Likith-Kasam/HydraSense/hardware/Components-Invoices/sky-electro-tech (2).jpg

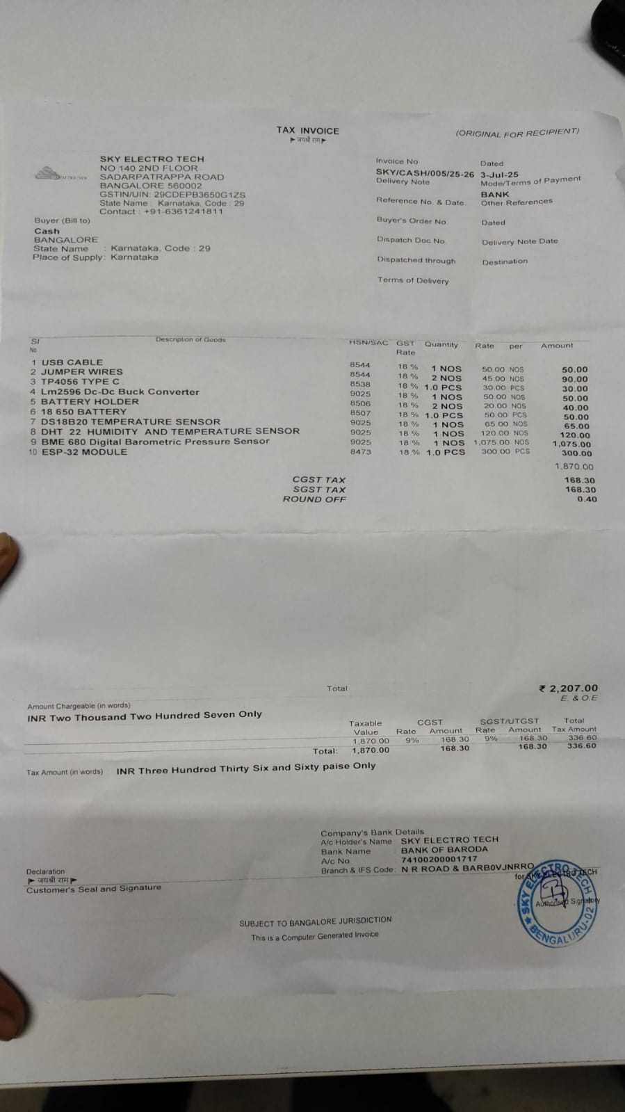
hardware/Components-Invoices/sky-electro-tech (2).jpg
