Likith-Kasam/HydraSense/hardware/Components-Invoices/sky-electro-tech(mehta).jpg

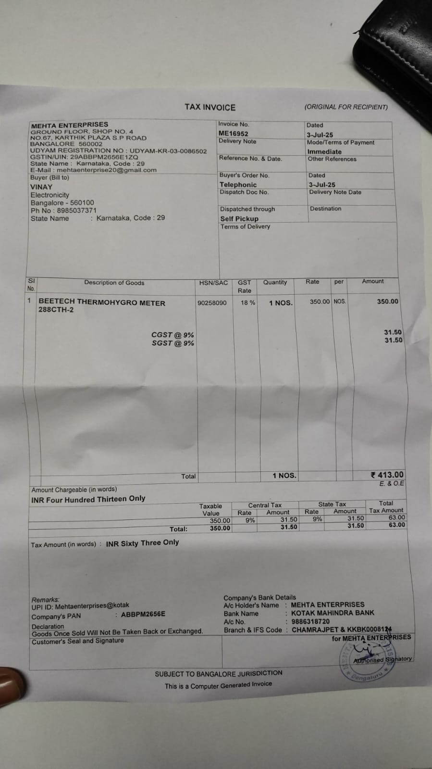
hardware/Components-Invoices/sky-electro-tech(mehta).jpg
