Likith-Kasam/HydraSense/demo/Hydra sense.pdf

# Hydra Sense

# TRL-8 Validated Cold Chain Monitoring

# ELCIIA

I T

# BANGALORE

# IIIT BANGALORE

# Team Members-LIKITH TARAL VINAY

# Team Members-LIKITH TARAL VINAY

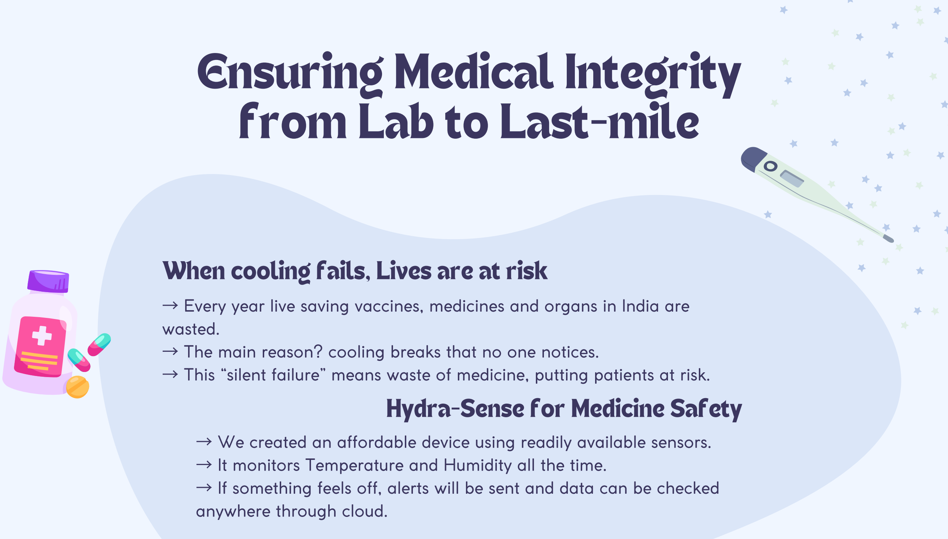
[picture p3: figure]
wasted.; → This; silent failure; When cooling fails, Lives are at risk; → We created an affordable; device using readily available sensors.; anywhere through cloud.; Hydra-Sense for Medicine Safety; Ensuring Medical Integrity from Lab to Last-mile

→ Every year live saving vaccines, medicines and organs in India are

→ The main reason? cooling breaks that no one notices.

means waste of medicine, putting patients at risk.

→ It monitors Temperature and Humidity all the time.

→ If something feels off, alerts will be sent and data can be checked

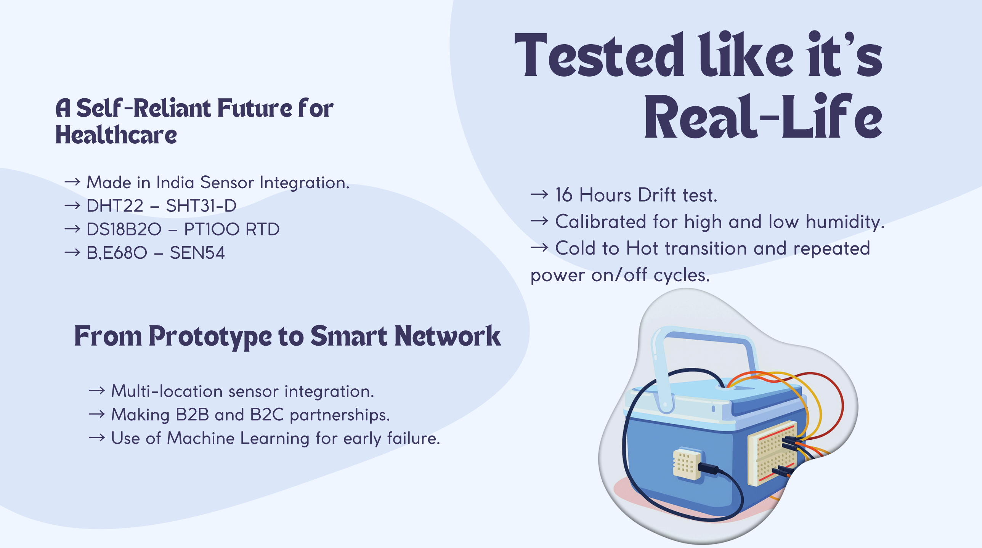
[picture p4: figure]
→ Made in India Sensor Integration.; → DHT22 – SHT31-D; → DS18B20 – PT100 RTD; → B,E680 – SEN54; → 16 Hours Drift test.; → Calibrated for high and low humidity.; → Cold to Hot transition and repeated; power on/off cycles.; A Self-Reliant Future for Healthcare; Tested like it’s Real-Life; From Prototype to Smart Network; → Multi-location sensor integration.; → Making B2B and B2C partnerships.

→ Use of Machine Learning for early failure.

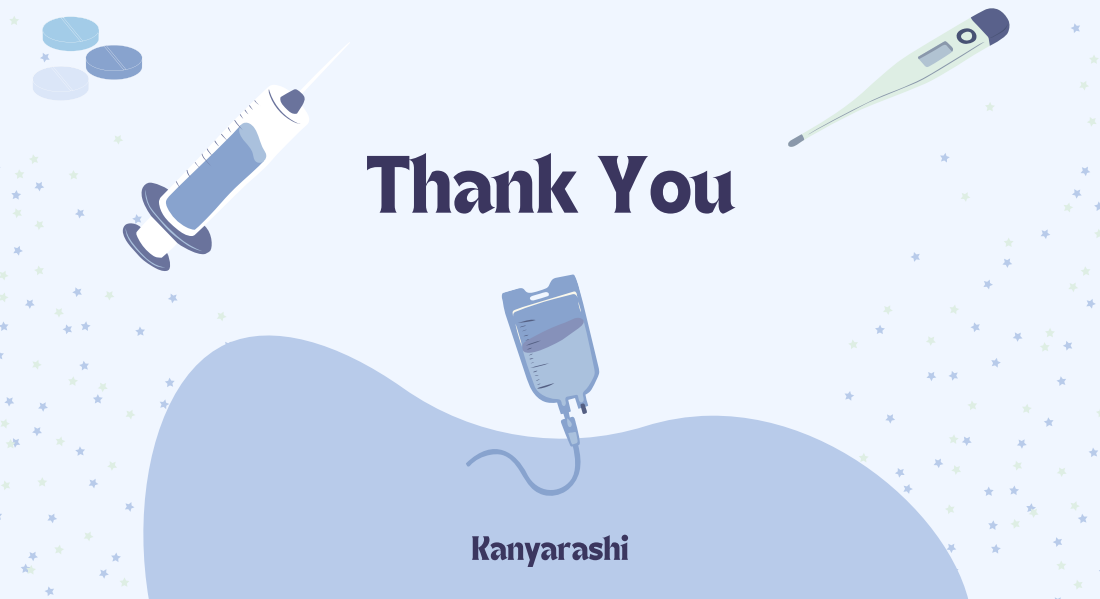
[picture p5: page 4]
Thank You; Kanyarashi
