Likith-Kasam/HydraSense/hardware/Circuit Diagram.jpg

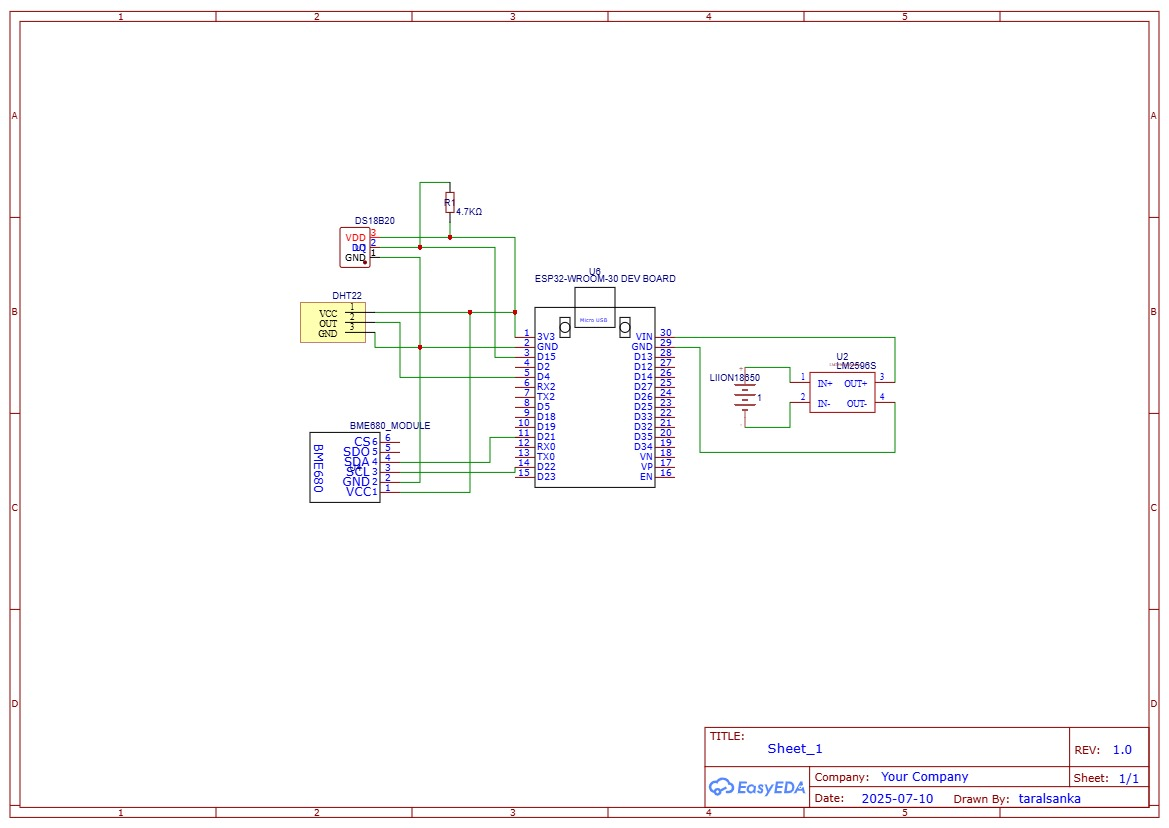
hardware/Circuit Diagram.jpg
