Likith-Kasam/HydraSense/test logs/screenshots/water-setup.png

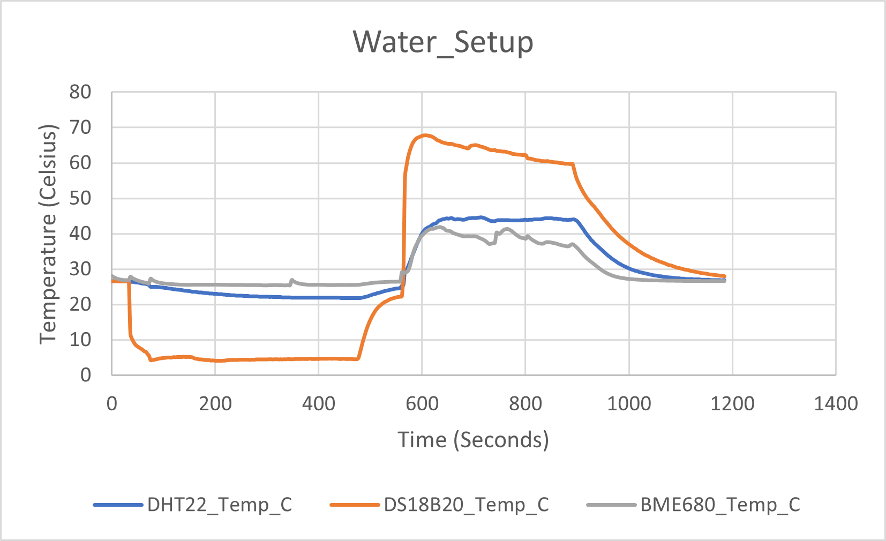
test logs/screenshots/water-setup.png
