Likith-Kasam/HydraSense/test logs/test-case-sensordata/16Hours_Data_Logging.csv

Time | DHT22_Temp | DS18B20_Temp | BME680_Temp | BME680_Humidity | DHT22_Humidity | BME680 - DS18B20 | BME680 - DHT22 Temp | DHT22 - BME680 (Humidity)
0 | 25.1 | 24.94 | 25.71 | 79.12 | 82.2 | 0.77 | 0.609999999999999 | 3.08
3 | 25.1 | 24.94 | 25.71 | 79.13 | 82.2 | 0.77 | 0.609999999999999 | 3.07000000000001
6 | 25.1 | 24.94 | 25.71 | 79.14 | 82.2 | 0.77 | 0.609999999999999 | 3.06
9 | 25.1 | 24.94 | 25.7 | 79.13 | 82.2 | 0.759999999999998 | 0.599999999999998 | 3.07000000000001
12 | 25.1 | 24.94 | 25.7 | 79.14 | 82.2 | 0.759999999999998 | 0.599999999999998 | 3.06
15 | 25.1 | 24.94 | 25.7 | 79.15 | 82.2 | 0.759999999999998 | 0.599999999999998 | 3.05
18 | 25.1 | 24.94 | 25.7 | 79.17 | 82.2 | 0.759999999999998 | 0.599999999999998 | 3.03
21 | 25.1 | 24.94 | 25.7 | 79.15 | 82.3 | 0.759999999999998 | 0.599999999999998 | 3.14999999999999
24 | 25.1 | 24.94 | 25.7 | 79.17 | 82.3 | 0.759999999999998 | 0.599999999999998 | 3.13
27 | 25.1 | 24.94 | 25.7 | 79.17 | 82.3 | 0.759999999999998 | 0.599999999999998 | 3.13
30 | 25.1 | 24.94 | 25.69 | 79.17 | 82.3 | 0.75 | 0.59 | 3.13
33 | 25.1 | 24.94 | 25.69 | 79.18 | 82.2 | 0.75 | 0.59 | 3.02
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
