Likith-Kasam/HydraSense/test logs/test-case-sensordata/Air_Testing.csv

Time | DHT22_Humidity_% | BME680_Humidity_%
0 | 74.8 | 76.36
3 | 74.9 | 75.85
6 | 74.9 | 76.32
9 | 74.9 | 76.66
12 | 74.8 | 76.74
15 | 74.8 | 76.7
18 | 74.9 | 76.63
21 | 75 | 76.55
24 | 75 | 76.44
27 | 75 | 76.32
30 | 75 | 76.17
33 | 75 | 74.98
36 | 74.9 | 74.4
39 | 75 | 74.76
42 | 74.9 | 75.36
45 | 74.8 | 74.79
48 | 74.7 | 75.24
51 | 74.8 | 75.77
54 | 74.9 | 75.97
57 | 74.9 | 76.13
60 | 74.9 | 76.26
63 | 75 | 76.38
66 | 75.1 | 76.49
69 | 75.2 | 76.61
72 | 75.3 | 76.67
75 | 75.4 | 76.8
78 | 75.5 | 76.88
81 | 75.6 | 76.94
84 | 75.7 | 77.08
87 | 75.9 | 77.16
90 | 76 | 77.2
93 | 76.1 | 77.25
96 | 76.2 | 77.32
99 | 76.3 | 77.41
102 | 76.5 | 77.49
105 | 76.6 | 77.55
108 | 76.7 | 77.62
111 | 76.8 | 77.67
114 | 76.9 | 77.74
117 | 77 | 77.79
120 | 77.9 | 78.26
123 | 78 | 77.45
126 | 78.1 | 77.72
129 | 78.2 | 77.92
132 | 78.2 | 78.07
135 | 78.2 | 78.17
138 | 78.3 | 78.24
141 | 78.4 | 78.3
144 | 78.4 | 78.33
147 | 78.4 | 78.36
150 | 78.5 | 78.39
153 | 78.5 | 78.42
156 | 78.6 | 78.44
159 | 78.6 | 78.45
162 | 78.6 | 78.47
165 | 78.7 | 78.47
168 | 78.7 | 78.48
171 | 78.8 | 78.5
174 | 78.7 | 78.51
177 | 78.7 | 78.52
180 | 78.8 | 78.53
183 | 78.8 | 78.55
186 | 78.8 | 78.56
189 | 78.9 | 78.55
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
