Likith-Kasam/HydraSense/test logs/test-case-sensordata/Salt_Slurry.csv

Time | DHT22 Humidity | BME680 Humidity | Target_75%
0 | 72.1 | 73.97 | 75
3 | 72.3 | 73.1 | 75
6 | 72.5 | 73.4 | 75
9 | 72.5 | 73.84 | 75
12 | 72.7 | 73.13 | 75
15 | 72.9 | 72.9 | 75
18 | 73.1 | 72.93 | 75
21 | 73.2 | 73.11 | 75
24 | 73.4 | 73.27 | 75
27 | 73.5 | 73.46 | 75
30 | 73.7 | 73.58 | 75
33 | 73.8 | 73.7 | 75
36 | 73.9 | 73.8 | 75
39 | 74 | 73.89 | 75
42 | 74 | 73.93 | 75
45 | 74.1 | 73.98 | 75
48 | 74.2 | 74.07 | 75
51 | 74.2 | 74.14 | 75
54 | 74.3 | 74.18 | 75
57 | 74.4 | 74.27 | 75
60 | 74.5 | 74.29 | 75
63 | 74.5 | 74.34 | 75
66 | 74.5 | 74.34 | 75
69 | 74.6 | 74.39 | 75
72 | 74.7 | 74.42 | 75
75 | 74.7 | 74.45 | 75
78 | 74.8 | 74.48 | 75
81 | 74.8 | 74.51 | 75
84 | 74.9 | 74.52 | 75
87 | 74.9 | 74.56 | 75
90 | 74.9 | 74.57 | 75
93 | 75 | 74.59 | 75
96 | 75 | 74.6 | 75
99 | 75.1 | 74.6 | 75
102 | 75 | 74.63 | 75
105 | 75.1 | 74.63 | 75
108 | 75.1 | 74.65 | 75
111 | 75.1 | 74.67 | 75
114 | 75.2 | 74.67 | 75
117 | 75.2 | 74.69 | 75
120 | 75.2 | 74.69 | 75
123 | 75.2 | 74.72 | 75
126 | 75.2 | 74.73 | 75
129 | 75.2 | 74.72 | 75
132 | 75.2 | 74.72 | 75
135 | 75.3 | 74.74 | 75
138 | 75.3 | 74.75 | 75
141 | 75.3 | 74.74 | 75
144 | 75.3 | 74.75 | 75
147 | 75.4 | 74.74 | 75
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
