Likith-Kasam/HydraSense/test logs/test-case-sensordata/Silica_Gel.csv

Time_Seconds | DHT22_Humidity (%) | BME680_Humidity (%)
0 | 81.88 | 79.87
3 | 82.25 | 79.84
6 | 82.02 | 79.66
9 | 81.61 | 79.85
12 | 81.33 | 79.39
15 | 81.03 | 79.52
18 | 80.94 | 79.39
21 | 81.51 | 79.12
24 | 80.95 | 79.26
27 | 81.04 | 78.9
30 | 80.16 | 78.92
33 | 80.57 | 78.53
36 | 80.57 | 78.36
39 | 80.11 | 78.53
42 | 79.81 | 78.35
45 | 80.29 | 78.19
48 | 79.78 | 77.94
51 | 79.64 | 78.2
54 | 79.58 | 77.54
57 | 79.35 | 77.4
60 | 79.41 | 77.7
63 | 78.69 | 77.56
66 | 79.2 | 77.33
69 | 79.11 | 77.08
72 | 79.04 | 77.11
75 | 78.84 | 77.22
78 | 78.47 | 77.26
81 | 78.17 | 76.29
84 | 78.4 | 76.41
87 | 77.87 | 76.27
90 | 77.85 | 76.56
93 | 77.75 | 75.61
96 | 77.55 | 76.08
99 | 77.67 | 75.79
102 | 77.6 | 76.04
105 | 77.07 | 75.88
108 | 77.11 | 75.52
111 | 76.42 | 75
114 | 76.6 | 75.07
117 | 76.47 | 74.95
120 | 76.36 | 74.65
123 | 76.38 | 75.01
126 | 75.77 | 74.35
129 | 76.2 | 74.9
132 | 75.22 | 74.76
135 | 75.45 | 74.16
138 | 75.12 | 74.17
141 | 75.45 | 73.95
144 | 75.18 | 74.01
147 | 74.75 | 73.94
150 | 75 | 73.6
153 | 75 | 73.51
156 | 74.58 | 73.15
159 | 74.17 | 73.23
162 | 74.35 | 73.03
165 | 74.17 | 72.68
168 | 73.76 | 72.72
171 | 73.46 | 72.51
174 | 73.08 | 72.33
177 | 73.32 | 72.09
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
