Likith-Kasam/HydraSense/test logs/screenshots/air-testing.png

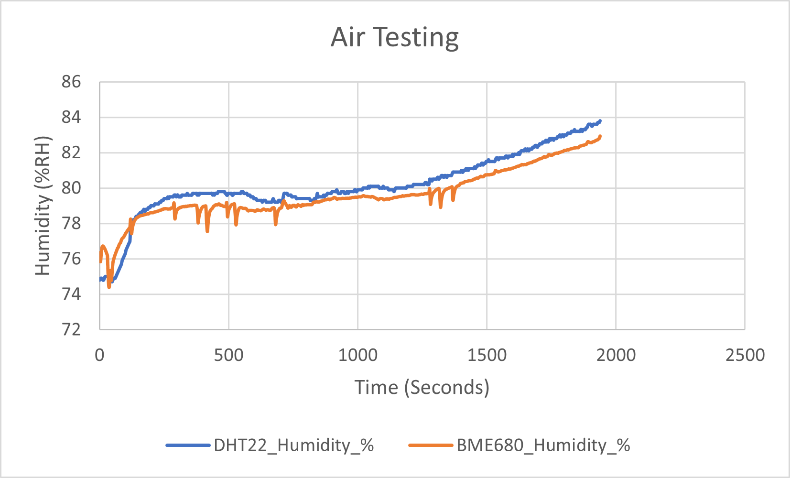
test logs/screenshots/air-testing.png
