Likith-Kasam/HydraSense/test logs/screenshots/blowing.png

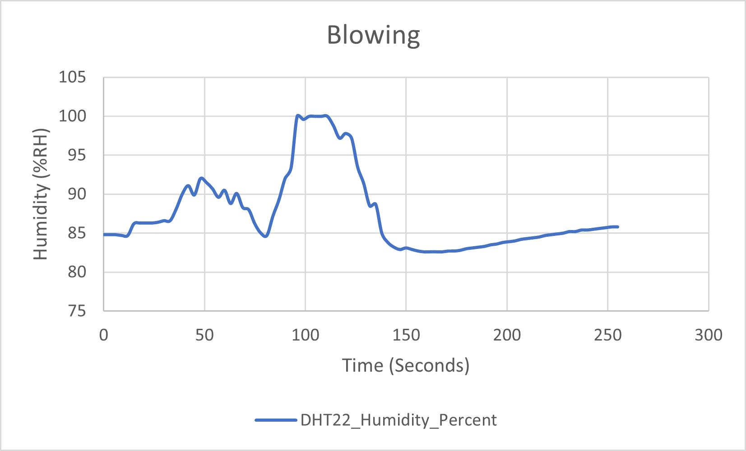
test logs/screenshots/blowing.png
