Likith-Kasam/HydraSense/test logs/screenshots/bme680-ds18b20(error).png

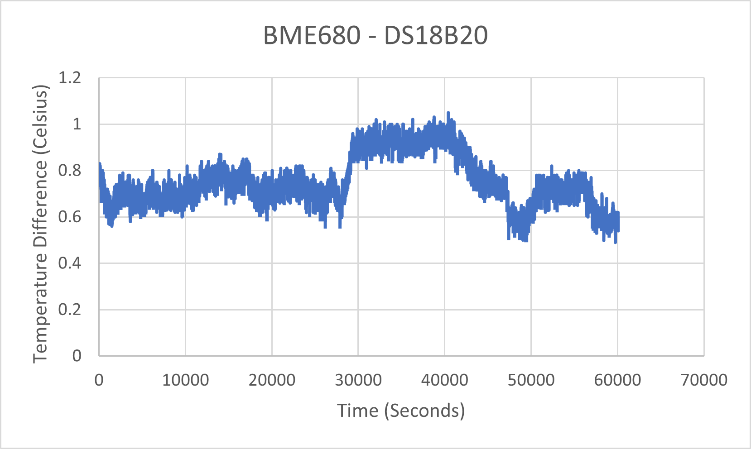
test logs/screenshots/bme680-ds18b20(error).png
