Likith-Kasam/HydraSense/test logs/screenshots/data-logging(temperature).png

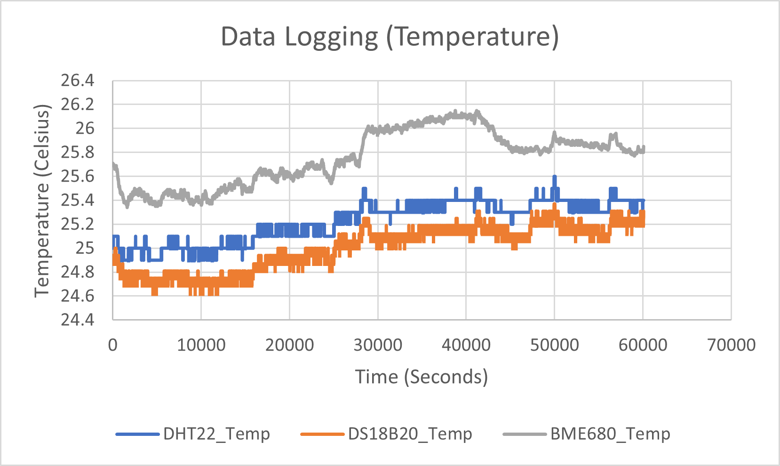
test logs/screenshots/data-logging(temperature).png
