Likith-Kasam/HydraSense/test logs/screenshots/salt-slurry.png

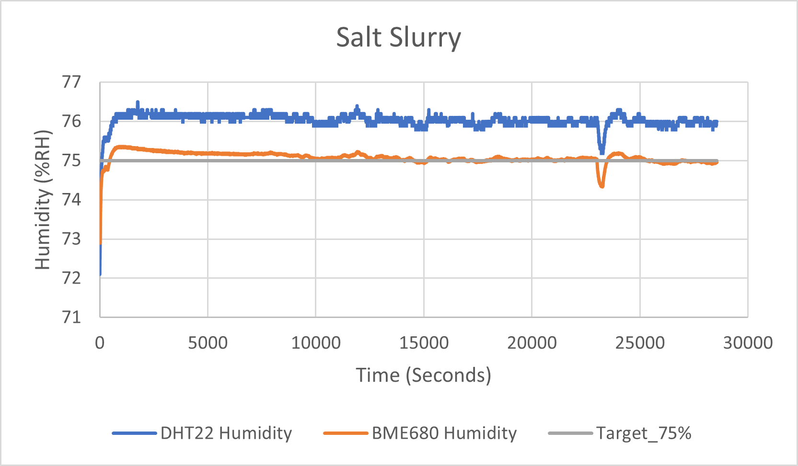
test logs/screenshots/salt-slurry.png
