Likith-Kasam/HydraSense/test logs/screenshots/Serial-Monitor.jpg

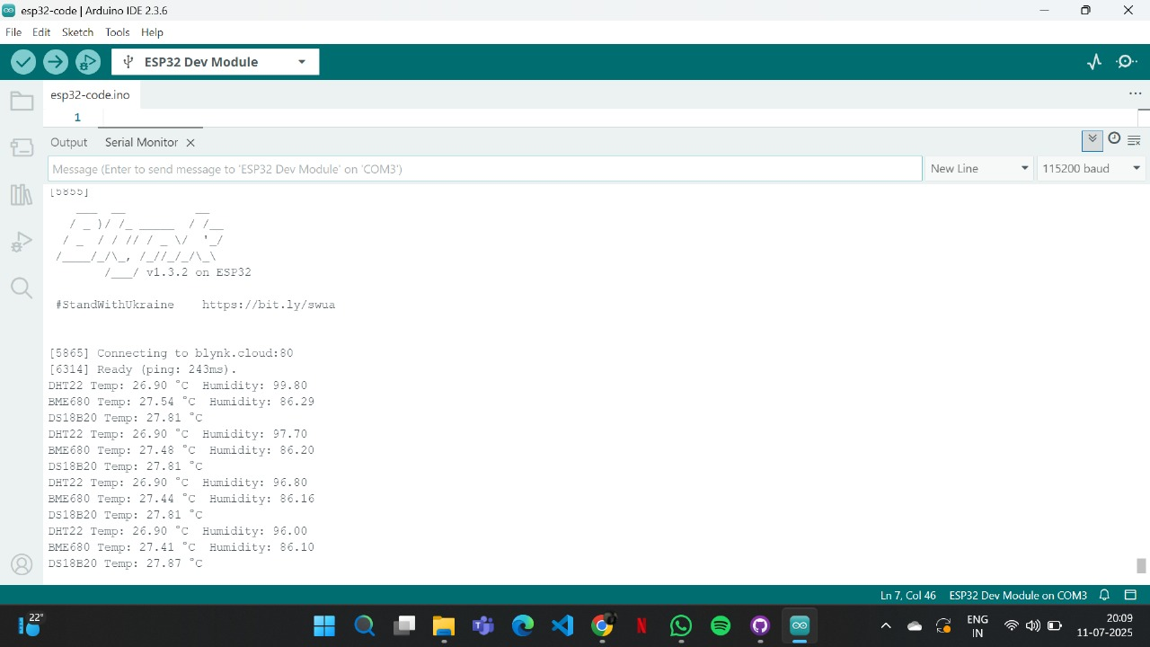
test logs/screenshots/Serial-Monitor.jpg
