Likith-Kasam/HydraSense/test logs/screenshots/silica-gel.png

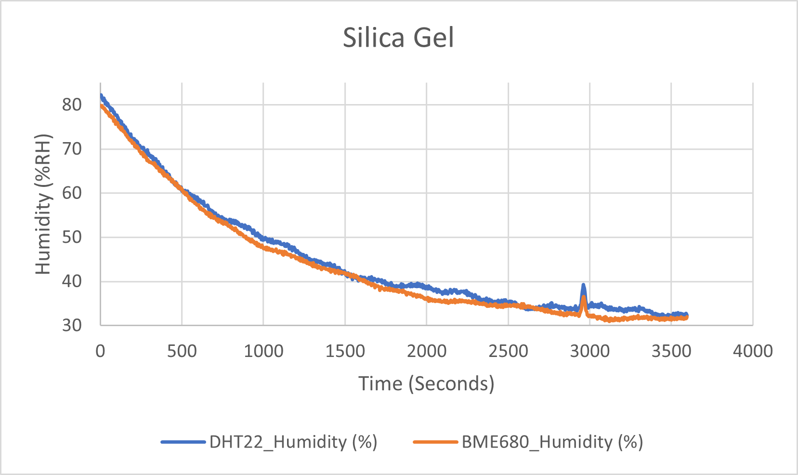
test logs/screenshots/silica-gel.png
