Likith-Kasam/HydraSense/(commit log)

2025-07-11 commit to git
    [16Hours_Data_Logging(Drift).xlsx, Air_Testing.xlsx, Blowing.xlsx, Salt_Slurry.xlsx, Silica_Gel.xlsx, Water_Setup.xlsx]
2025-07-11 Update to git
    [16Hours_Data_Logging(Drift).xlsx, 16Hours_Data_Logging.csv, Air_Testing.csv, Air_Testing.xlsx, Blowing.csv, Blowing.xlsx, Salt_Slurry.csv, Salt_Slurry.xlsx]
